Spritetm/eink_digit_clock/README.md

E-ink digit clock thing
-----------------------

In this repo:

- firmware - Firmware for the ESP32C6. It's intended for ESP-IDF 5.2.0.

- gendigits - code to take digits from a TrueType font, render and compress them

- pcb - PCB artwork for Kicad 8.
