Spritetm/eink_digit_clock/gendigits/fonts/Catbrother.jpg

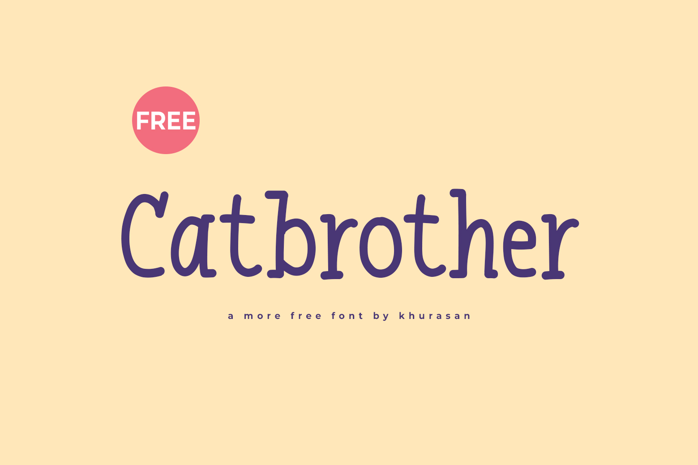
gendigits/fonts/Catbrother.jpg
