Spritetm/eink_digit_clock/gendigits/fonts/folder.jpg

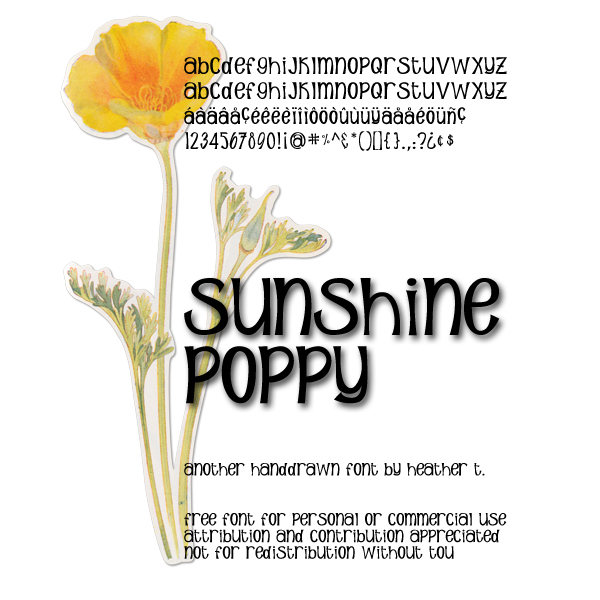
gendigits/fonts/folder.jpg
