Spritetm/eink_digit_clock/gendigits/fonts/sugar.gif

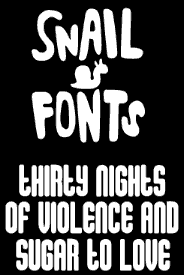
gendigits/fonts/sugar.gif
