Spritetm/eink_digit_clock/pcb/gerber/eink_digit_clk-PTH-drl_map.dxf

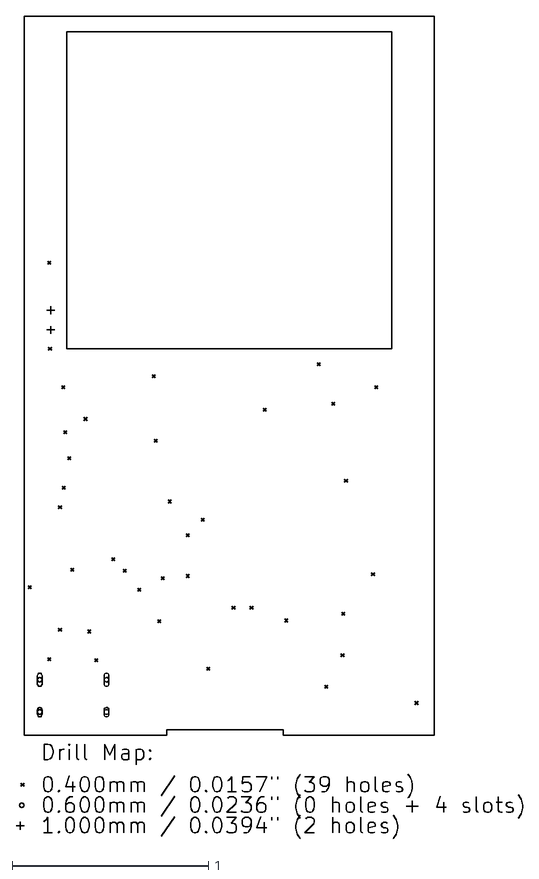
[picture p4: CAD file, 2024-03-09]
pcb/gerber/eink_digit_clk-PTH-drl_map.dxf
2.58 x 4.19
