Spritetm/eink_digit_clock/pcb/gerber/eink_digit_clk-NPTH-drl_map.dxf

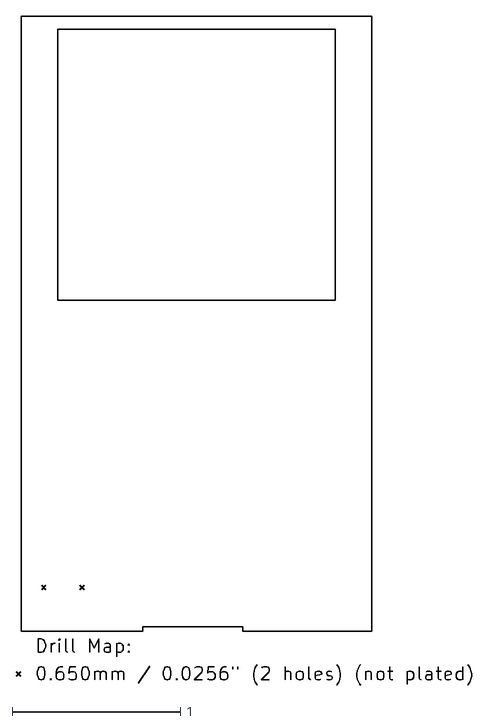
[picture p5: CAD file, 2024-03-09]
pcb/gerber/eink_digit_clk-NPTH-drl_map.dxf
2.71 x 3.98
