Spritetm/eink_digit_clock/pcb/eink_digit_clk.kicad_pcb

## KiCad design pcb/eink_digit_clk.kicad_pcb (2024-06-04)

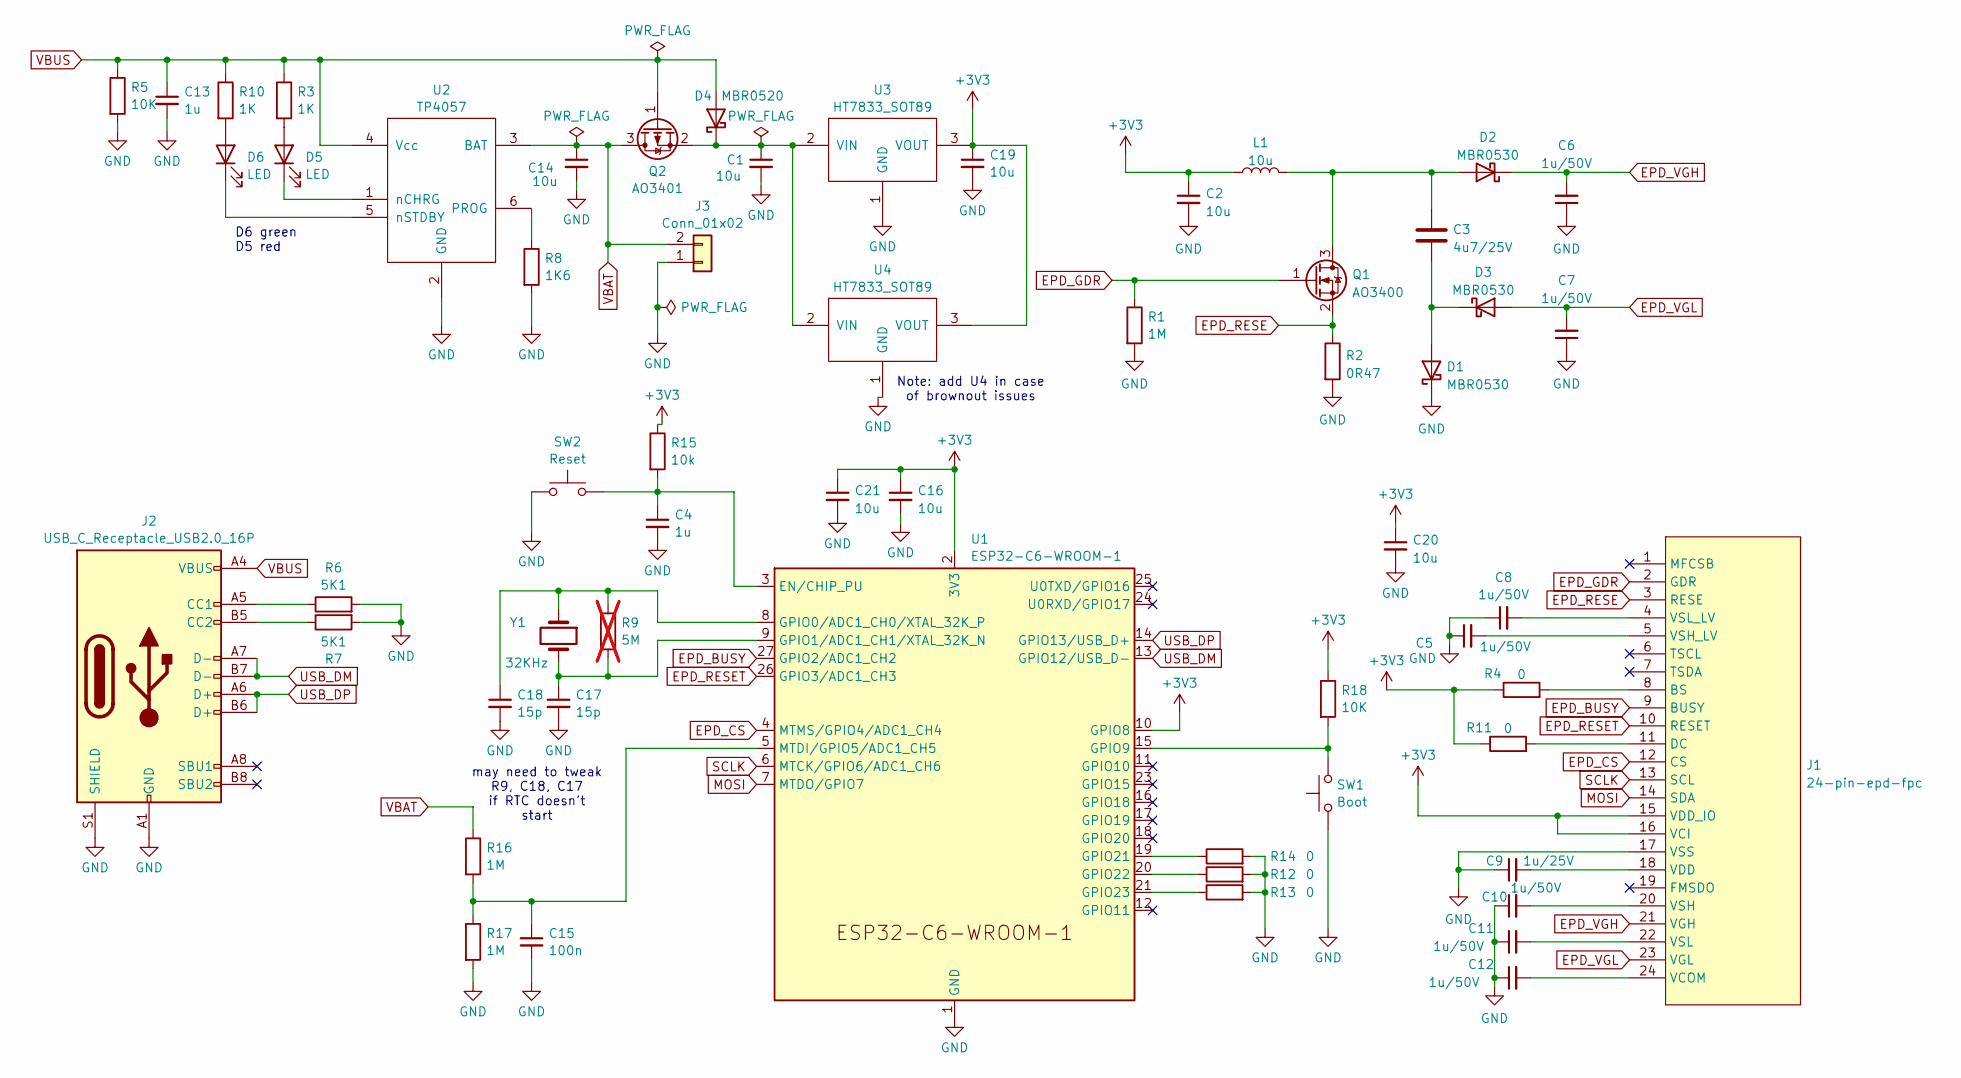
[picture p6: schematic eink_digit_clk.kicad_sch]

Parts:
C1, C2, C14, C16, C19, C20, C21: 10u; C_0805_2012Metric
C3: 4u7/25V; C_0603_1608Metric
C4, C13: 1u; C_0603_1608Metric
C5, C6, C7, C8, C10, C11, C12: 1u/50V; C_0603_1608Metric
C9: 1u/25V; C_0603_1608Metric
C15: 100n; C_0603_1608Metric
C17, C18: 15p; C_0603_1608Metric
D1, D2, D3: MBR0530; D_SOD-123
D4: MBR0520; D_SOD-123
D5, D6: LED; LED_0603_1608Metric
J1: 24-pin-epd-fpc; Hirose_FH12-24S-0.5SH_1x24-1MP_P0.50mm_Horizontal_reverse
J2: USB_C_Receptacle_USB2.0_16P; USB_C_Receptacle_HRO_TYPE-C-31-M-12
J3: Conn_01x02; PinHeader_1x02_P2.54mm_Vertical
L1: 10u; L_Sunlord_SWPA4012S
Q1: AO3400; SOT-23
Q2: AO3401; SOT-23
R1, R16, R17: 1M; R_0603_1608Metric
R2: 0R47; R_0603_1608Metric
R3, R10: 1K; R_0603_1608Metric
R4, R11, R12, R13, R14: 0; R_0603_1608Metric
R5, R18: 10K; R_0603_1608Metric
R6, R7: 5K1; R_0603_1608Metric
R8: 1K6; R_0603_1608Metric
R9: 5M; R_0603_1608Metric; not fitted
R15: 10k; R_0603_1608Metric
SW1: Boot; SW_SPST_B3S-1000
SW2: Reset; SW_SPST_B3S-1000
U1: ESP32-C6-WROOM-1
U2: TP4057; SOT-23-6
U3, U4: HT7833_SOT89; SOT-89-3
Y1: 32KHz; Crystal_SMD_3215-2Pin_3.2x1.5mm

Connections:
+3V3: C2.1, C16.1, C19.1, C20.1, C21.1, J1.15 (VDD_IO), J1.16 (VCI), L1.1, R4.1, R11.1, R15.1, R18.1, U1.2 (3V3), U1.10 (GPIO8), U3.3 (VOUT), U4.3 (VOUT)
EPD_BUSY: J1.9 (BUSY), U1.27 (GPIO2/ADC1_CH2)
EPD_CS: J1.12 (CS), U1.4 (MTMS/GPIO4/ADC1_CH4)
EPD_GDR: J1.2 (GDR), Q1.1 (G), R1.1
EPD_RESE: J1.3 (RESE), Q1.2 (S), R2.1
EPD_RESET: J1.10 (RESET), U1.26 (GPIO3/ADC1_CH3)
EPD_VGH: C6.2, D2.1 (K), J1.21 (VGH)
EPD_VGL: C7.2, D3.2 (A), J1.23 (VGL)
GND: C1.2, C2.2, C4.2, C5.1, C6.1, C7.1, C8.1, C9.1, C10.1, C11.1, C12.1, C13.2, C14.2, C15.2, C16.2, C17.2, C18.2, C19.2, C20.2, C21.2, D1.1 (K), J1.17 (VSS), J2.A1 (GND), J2.A12 (GND), J2.B1 (GND), J2.B12 (GND), J2.S1 (SHIELD), J3.1, R1.2, R2.2, R5.2, R6.2, R7.2, R8.2, R12.2, R13.2, R14.2, R17.2, SW1.1, SW2.1, U1.1 (GND), U1.28 (GND), U1.29 (GND), U2.2 (GND), U3.1 (GND), U4.1 (GND)
MOSI: J1.14 (SDA), U1.7 (MTDO/GPIO7)
unnamed: C3.2, D1.2 (A), D3.1 (K)
unnamed: C3.1, D2.2 (A), L1.2, Q1.3 (D)
unnamed: C1.1, D4.1 (K), Q2.2 (S), U3.2 (VIN), U4.2 (VIN)
unnamed: D5.2 (A), R3.2
unnamed: D5.1 (K), U2.1 (nCHRG)
unnamed: D6.2 (A), R10.2
unnamed: D6.1 (K), U2.5 (nSTDBY)
unnamed: J1.8 (BS), R4.2
unnamed: J1.11 (DC), R11.2
unnamed: C12.2, J1.24 (VCOM)
unnamed: C9.2, J1.18 (VDD)
unnamed: C10.2, J1.20 (VSH)
unnamed: C5.2, J1.5 (VSH_LV)
unnamed: C11.2, J1.22 (VSL)
unnamed: C8.2, J1.4 (VSL_LV)
unnamed: J2.A5 (CC1), R6.1
unnamed: J2.B5 (CC2), R7.1
unnamed: C4.1, R15.2, SW2.2, U1.3 (EN/CHIP_PU)
unnamed: C18.1, R9.1, U1.8 (GPIO0/ADC1_CH0/XTAL_32K_P), Y1.1
unnamed: C17.1, R9.2, U1.9 (GPIO1/ADC1_CH1/XTAL_32K_N), Y1.2
unnamed: R18.2, SW1.2, U1.15 (GPIO9)
unnamed: R14.1, U1.19 (GPIO21)
unnamed: R12.1, U1.20 (GPIO22)
unnamed: R13.1, U1.21 (GPIO23)
unnamed: C15.1, R16.2, R17.1, U1.5 (MTDI/GPIO5/ADC1_CH5)
unnamed: R8.1, U2.6 (PROG)
SCLK: J1.13 (SCL), U1.6 (MTCK/GPIO6/ADC1_CH6)
USB_DM: J2.A7 (D-), J2.B7 (D-), U1.13 (GPIO12/USB_D-)
USB_DP: J2.A6 (D+), J2.B6 (D+), U1.14 (GPIO13/USB_D+)
VBAT: C14.1, J3.2, Q2.3 (D), R16.1, U2.3 (BAT)
VBUS: C13.1, D4.2 (A), J2.A4 (VBUS), J2.A9 (VBUS), J2.B4 (VBUS), J2.B9 (VBUS), Q2.1 (G), R3.1, R5.1, R10.1, U2.4 (Vcc)

Notes on the sheet:
may need to tweak R9, C18, C17 if RTC doesn't start
D6 green D5 red
Note: add U4 in case of brownout issues

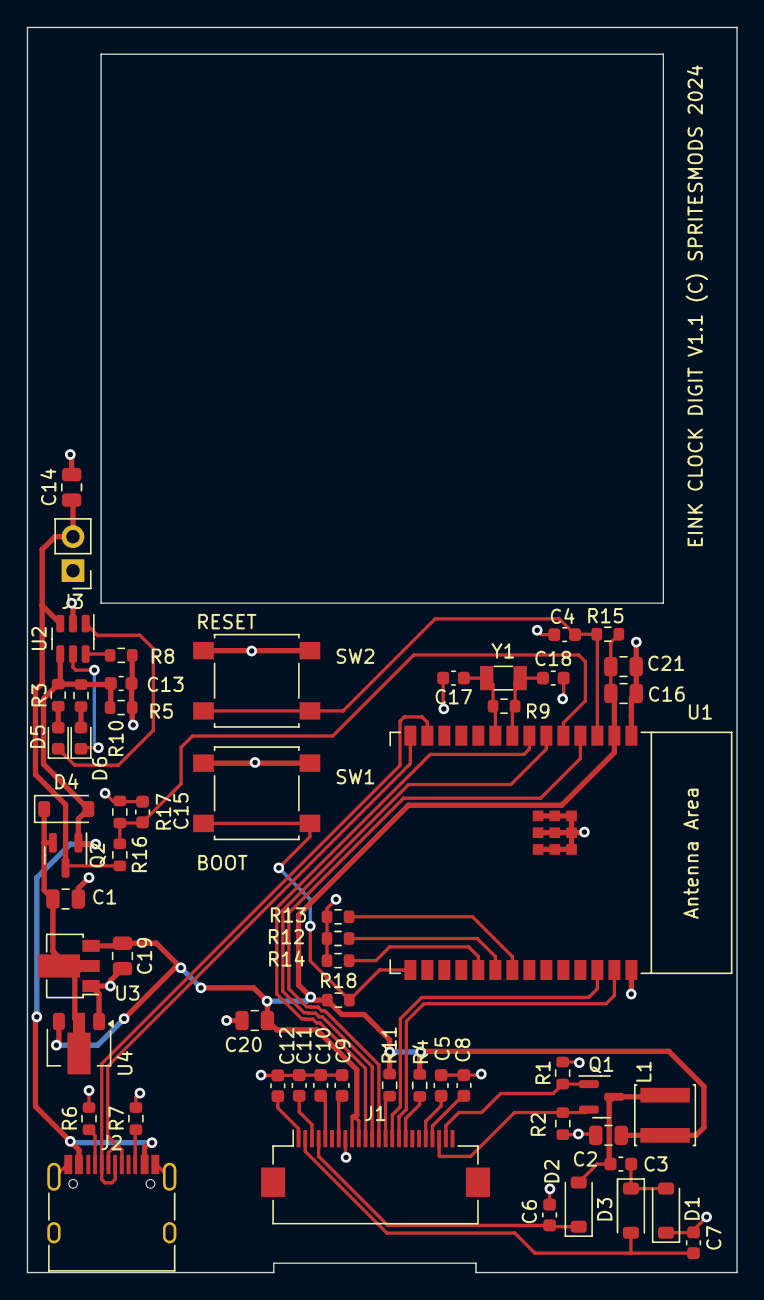
[picture p7: board eink_digit_clk.kicad_pcb from above]

Board: 2 copper layers, 53.0 x 93.0 mm, 58 parts (0 on the bottom side), 41 nets.
