Spritetm/eink_digit_clock/firmware/main/io.h

//IO definitions

#define IO_EPD_BUSY 2
#define IO_EPD_RESET 3
#define IO_EPD_CS 4
#define IO_EPD_SCLK 6
#define IO_EPD_MOSI 7

#define IO_ID0 21
#define IO_ID1 22
#define IO_ID2 23
