Spritetm/eink_digit_clock/(commit log)

2024-03-09 Initial commit. Got ULP displaying numbers.
    [eink_digit_clk-B_Cu.gbr, eink_digit_clk-B_Mask.gbr, eink_digit_clk-B_Paste.gbr, eink_digit_clk-B_Silkscreen.gbr, eink_digit_clk-Edge_Cuts.gbr, eink_digit_clk-F_Cu.gbr, eink_digit_clk-F_Mask.gbr, eink_digit_clk-F_Paste.gbr]
2024-03-14 It works, but with ntp sync, so the digits will drift apart
    [eink_digit_clk.kicad_sch]
2024-06-04 Fix issues in schematic/pcb
    [eink_digit_clk.kicad_pcb, eink_digit_clk.kicad_sch]
2024-06-04 Show errors if something goes wrong
    [epd_w21.c, main.c]
